LucaLombardini/fft_sylvester_ii/README.txt

################################################################################
#       Progetto di un circuito digitale per il calcolo FFT basato 
#       sull’algoritmo Cooley-Tukey (Project of a digital circuit dedicated to 
#       the FFT calculus based on Cooley-Tuckey algorithm)
################################################################################
#       AUTHORS:
#               Luca Lombardini
#                       Contacts:       s277972@studenti.polito.it
#                                       lombamari2@gmail.com
################################################################################
#       PURPOSE:
#               (Master Degree) Sistemi digitali integrati course's project
################################################################################
#       ACADEMIC YEAR:  2020/2021
################################################################################
#       GOAL:
#               Design in VHDL language a dedicated digital circuit, compliant 
#               to the given specifications, able to calculate the DFT of a 
#               digital input, using the Cooley-Tuckey algorithm. Then document 
#               the obtained performance.
################################################################################
#       LICENSE: GPL-2.0
################################################################################
