LucaLombardini/fft_sylvester_ii/project_files/control_unit.png

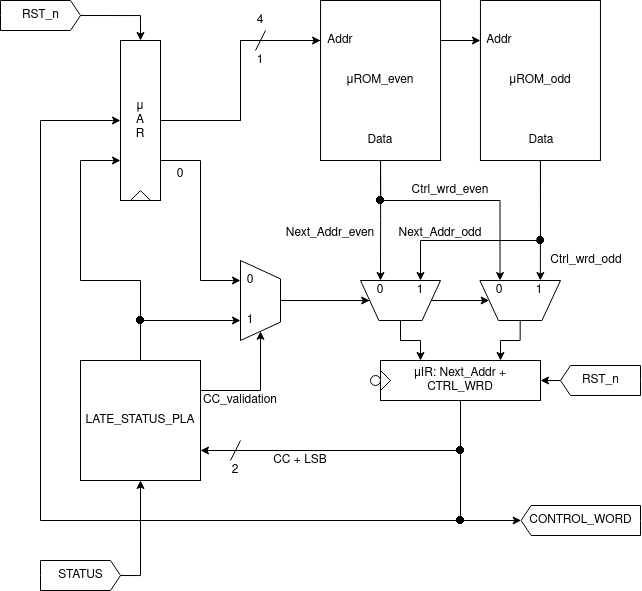
project_files/control_unit.png
