LucaLombardini/fft_sylvester_ii/project_files/ctrlwrds_pt1.png

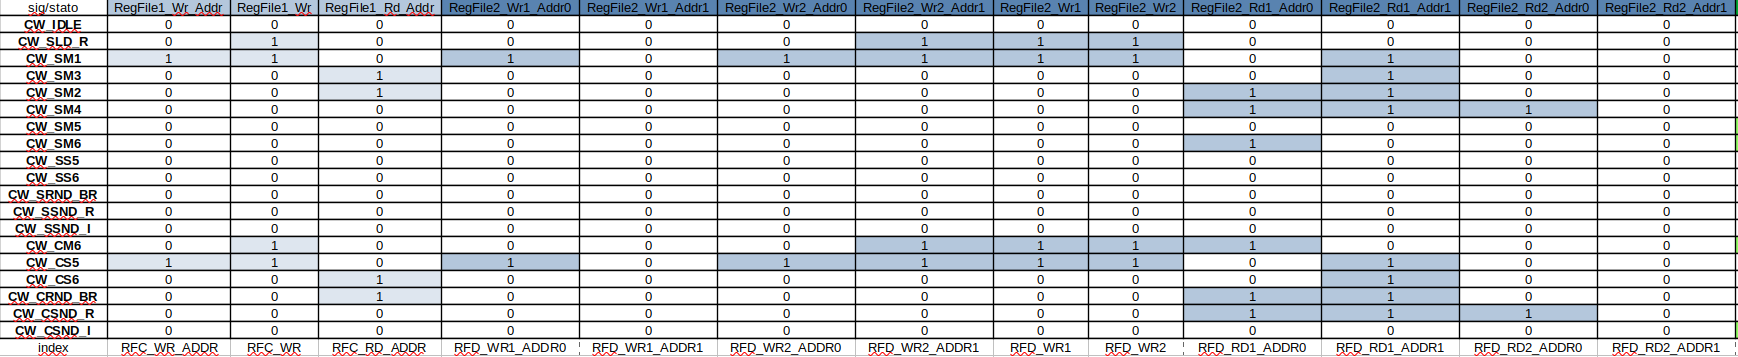
project_files/ctrlwrds_pt1.png
