LucaLombardini/fft_sylvester_ii/project_files/ctrlwrds_pt2.png

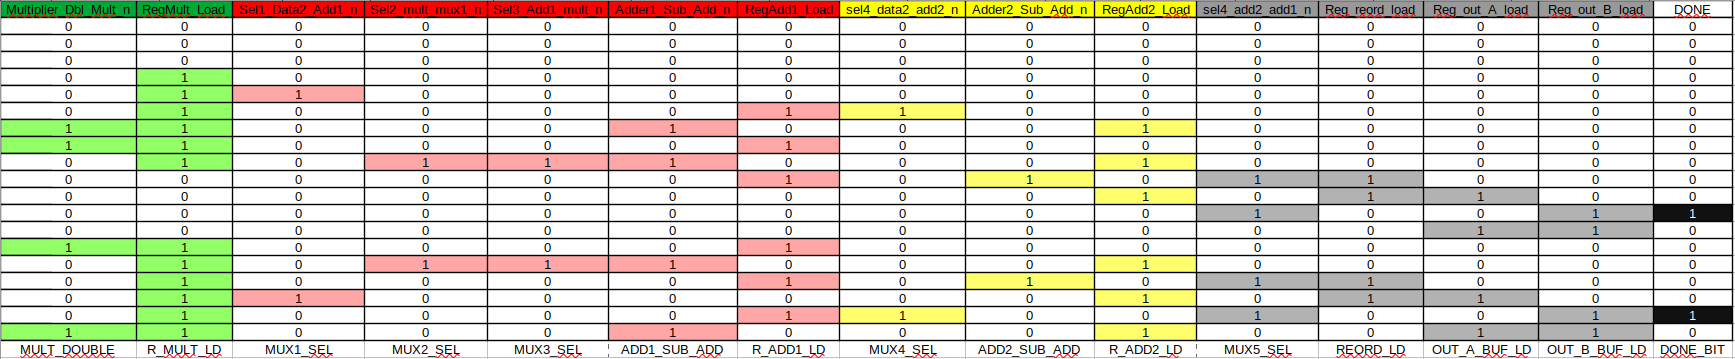
project_files/ctrlwrds_pt2.png
