LucaLombardini/fft_sylvester_ii/project_files/datapath_1_cross.png

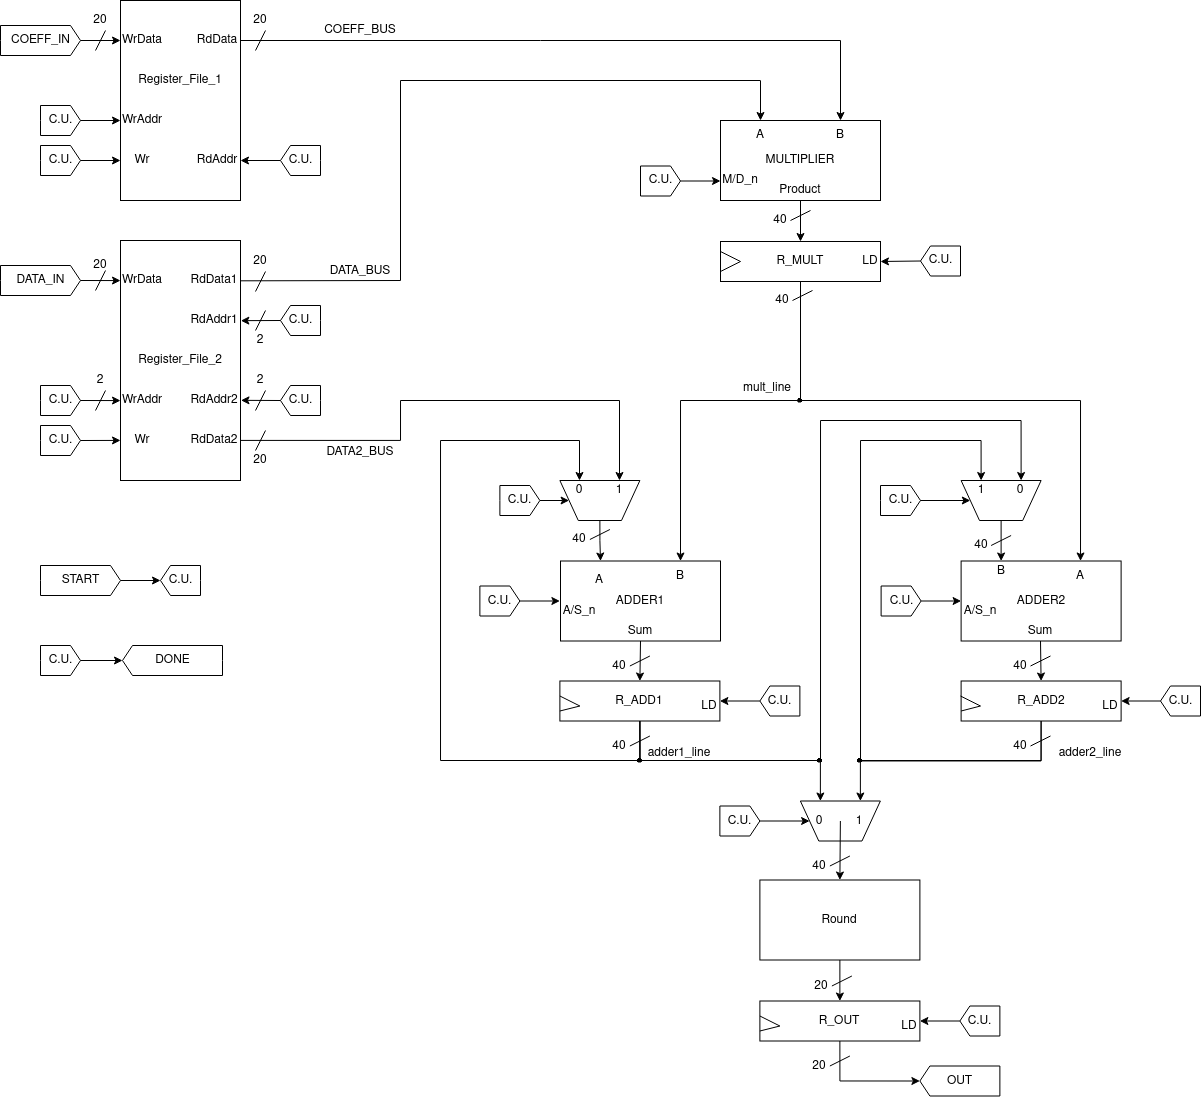
project_files/datapath_1_cross.png
