LucaLombardini/fft_sylvester_ii/project_files/datapath_2.png

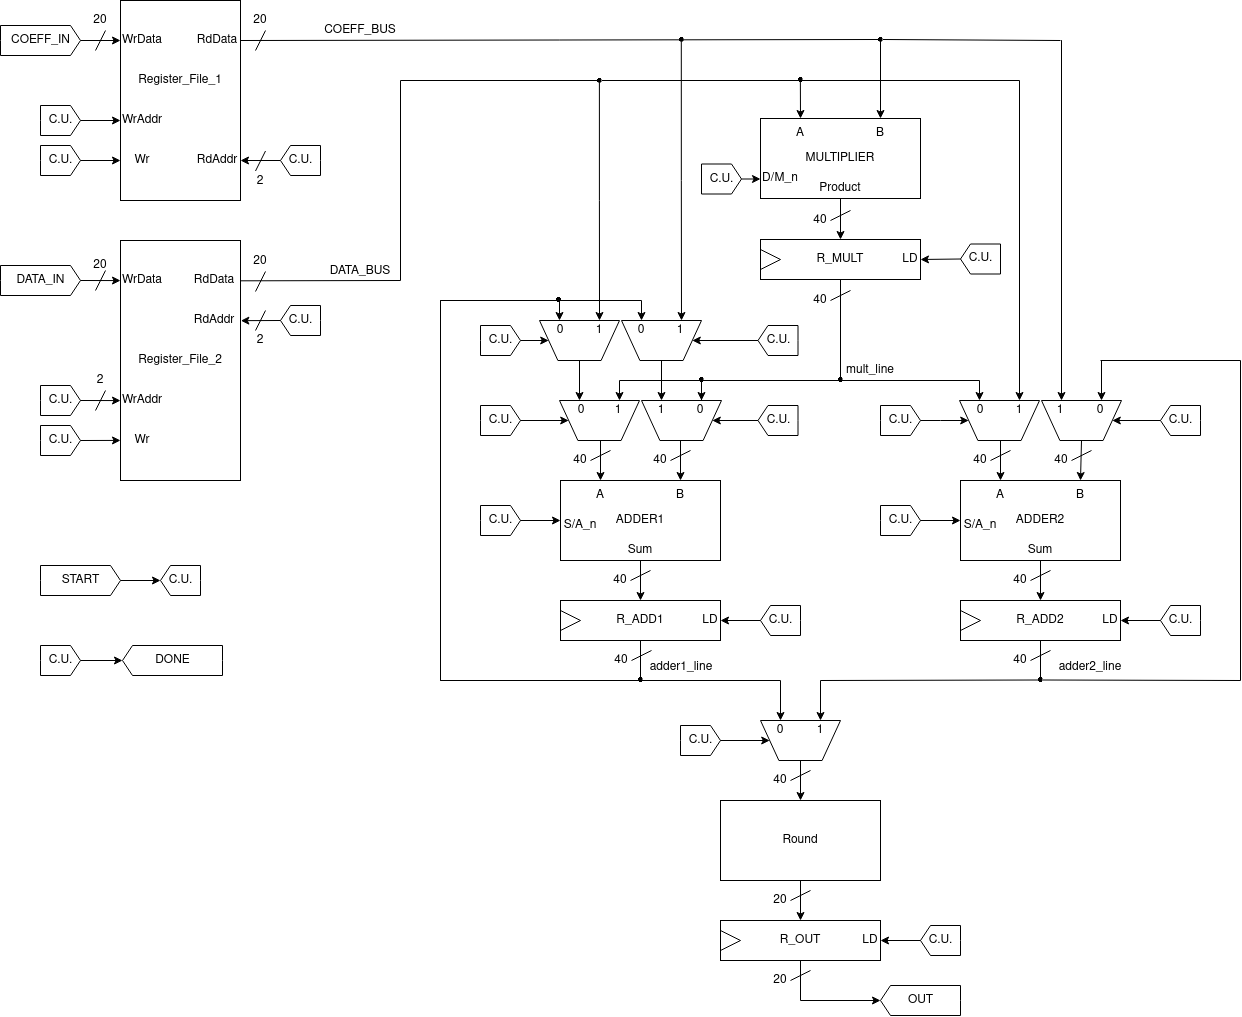
project_files/datapath_2.png
