LucaLombardini/fft_sylvester_ii/project_files/datapath_2_dual_in_nobus.png

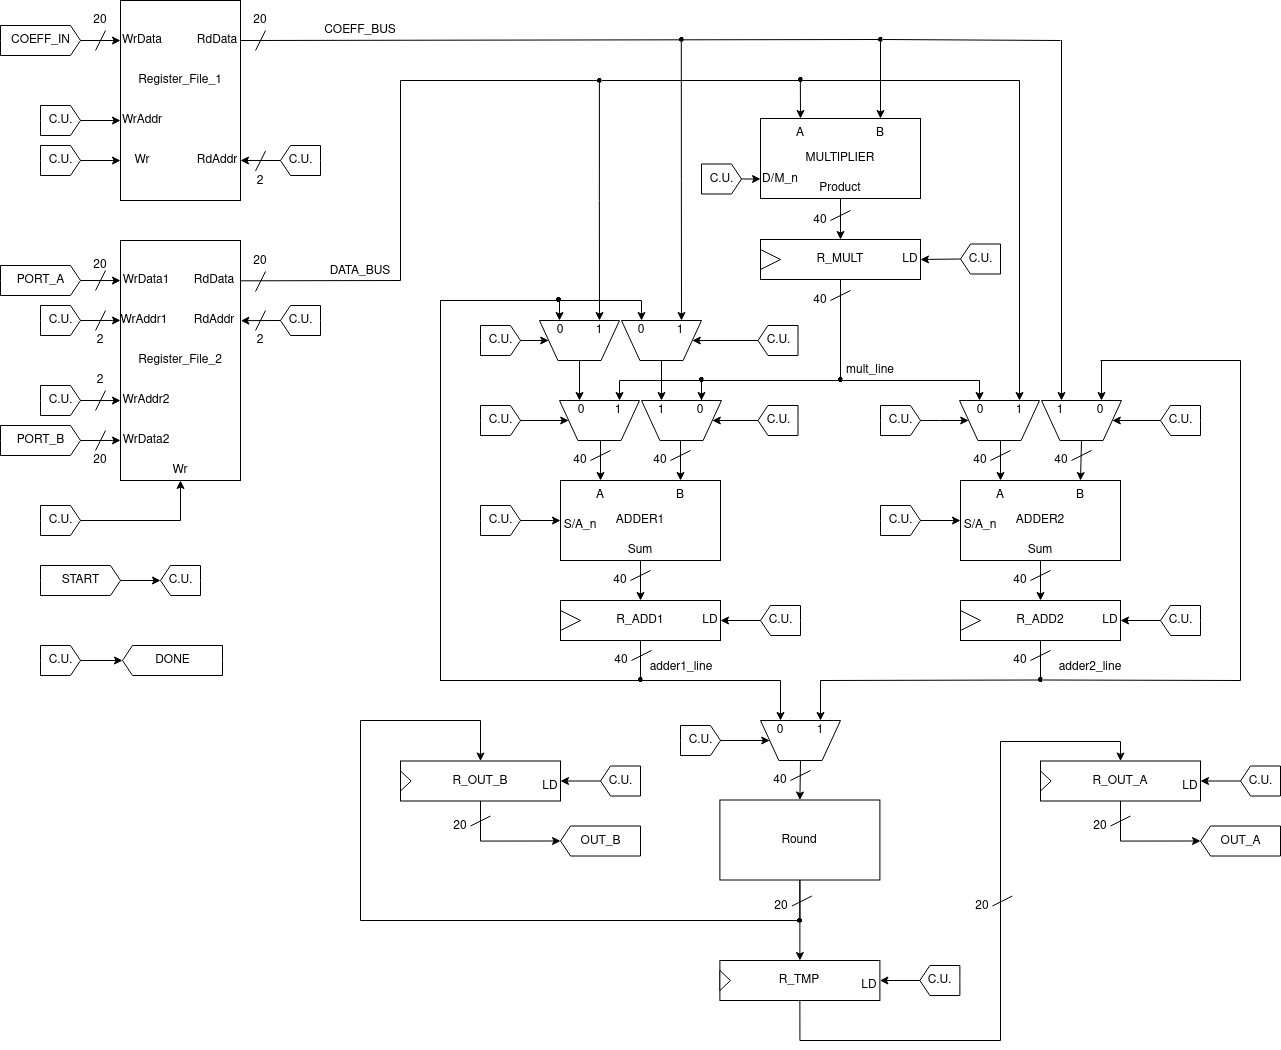
project_files/datapath_2_dual_in_nobus.png
