LucaLombardini/fft_sylvester_ii/project_files/datapath_3.png

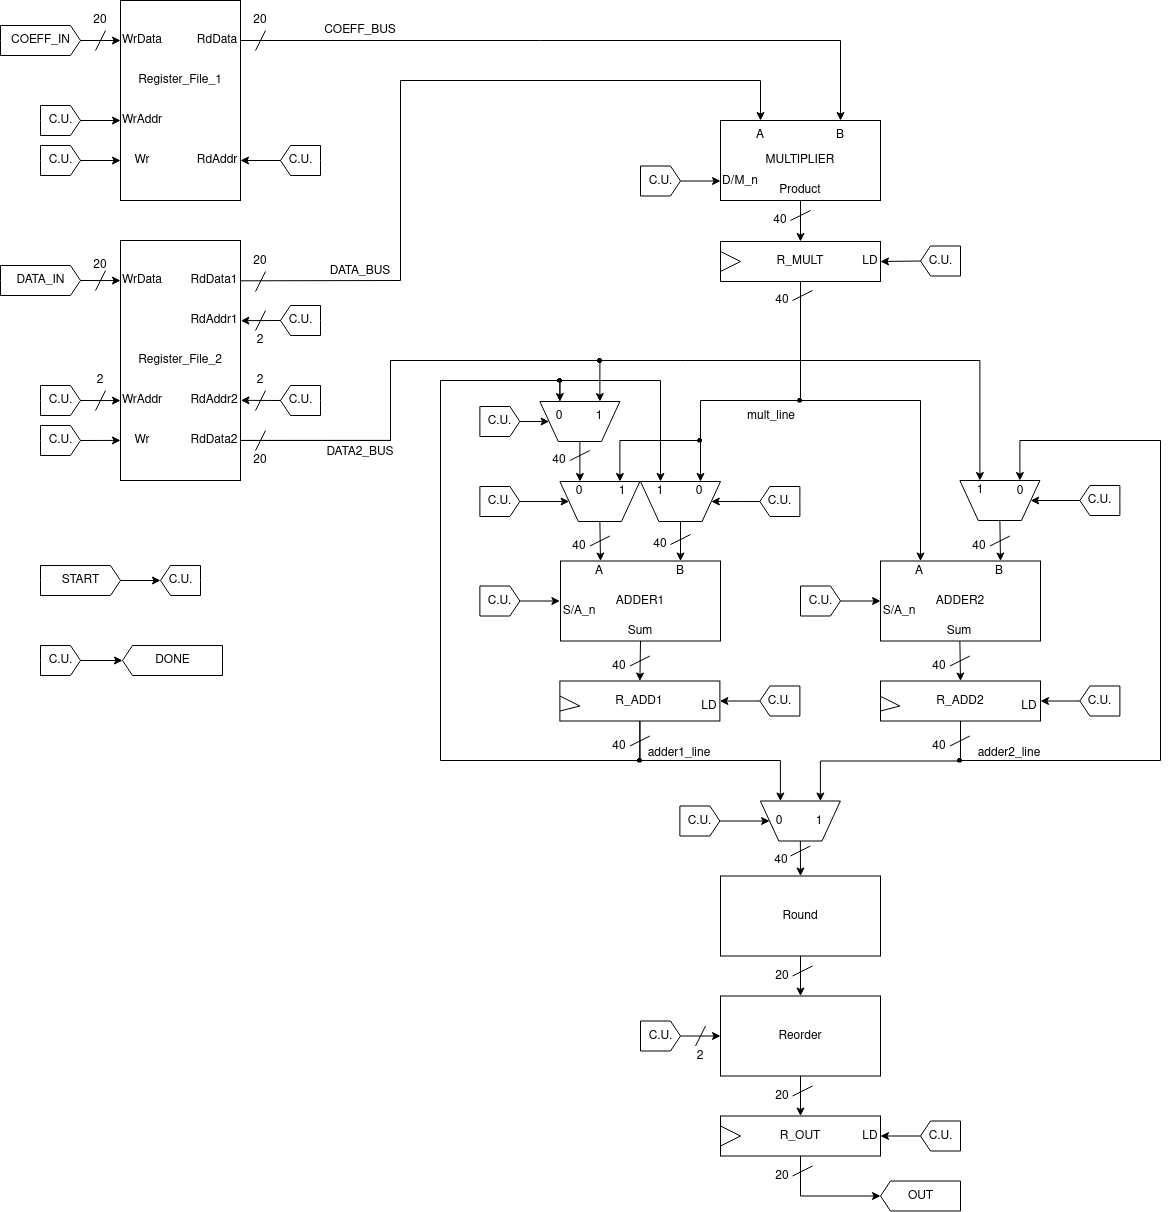
project_files/datapath_3.png
