LucaLombardini/fft_sylvester_ii/project_files/datapath_3_cross.png

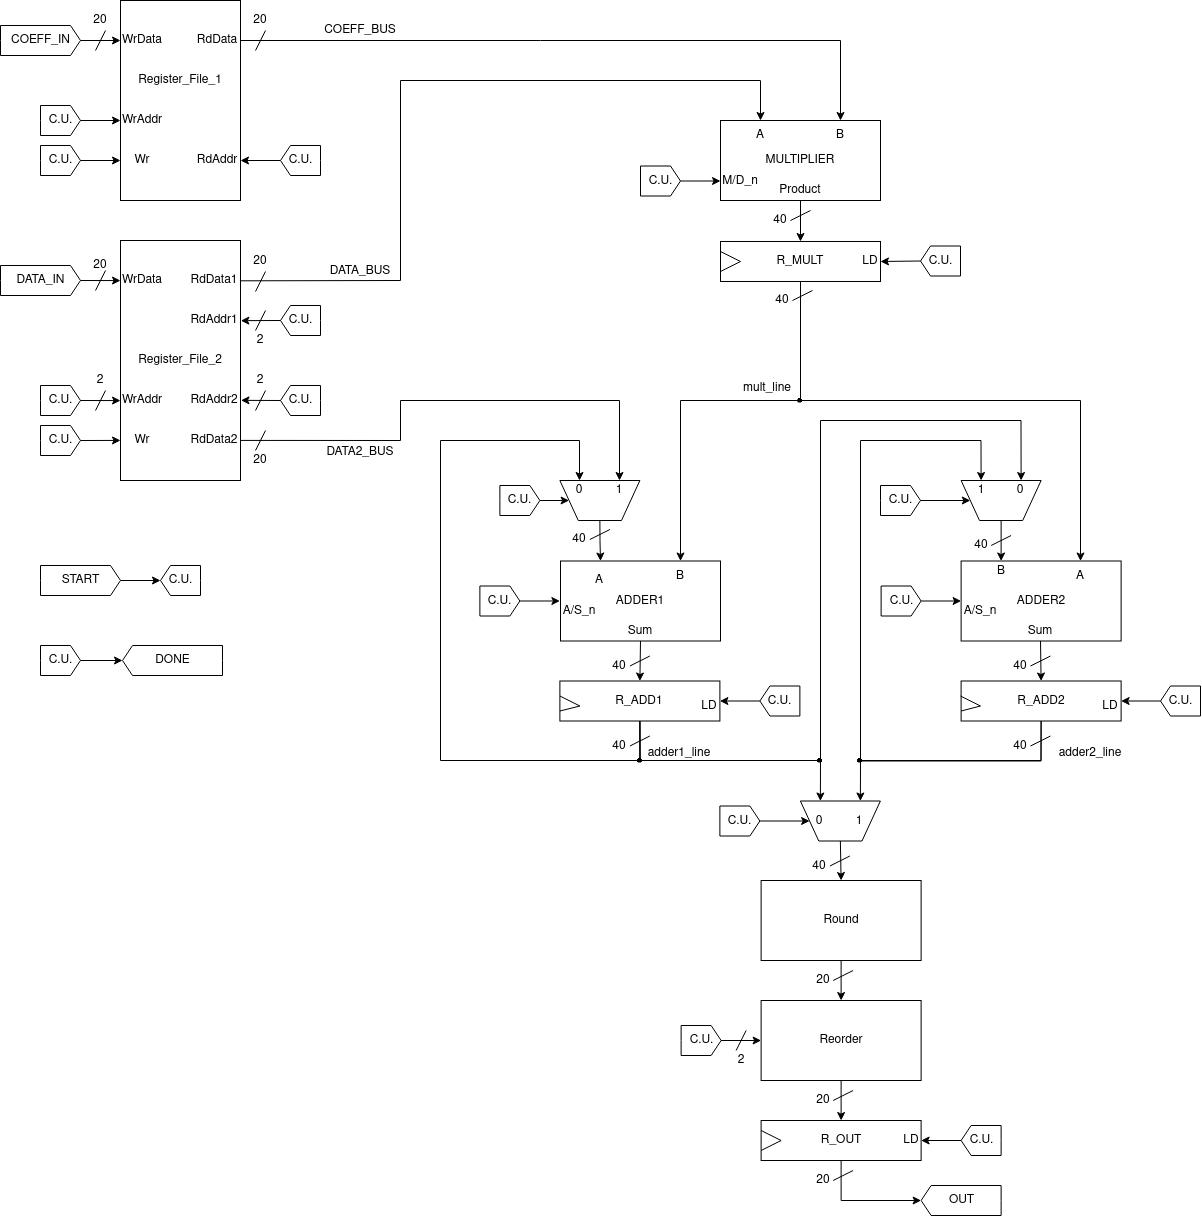
project_files/datapath_3_cross.png
