LucaLombardini/fft_sylvester_ii/project_files/hybrid_2_color.png

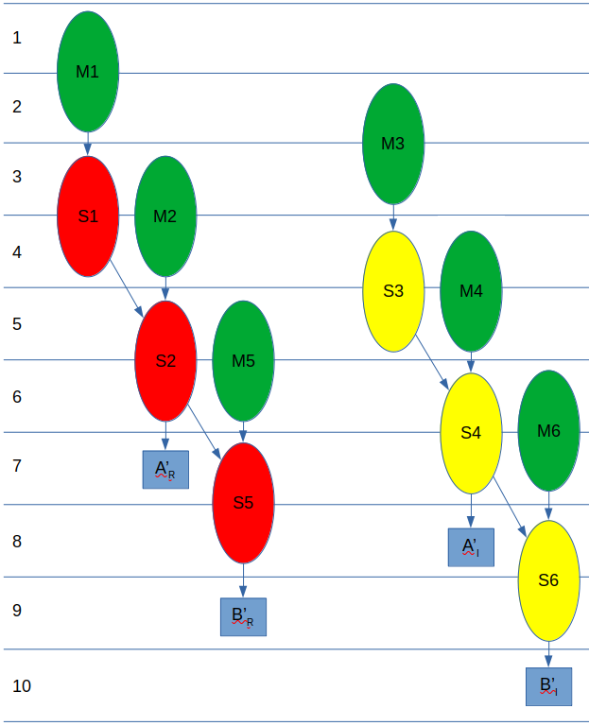
project_files/hybrid_2_color.png
