LucaLombardini/fft_sylvester_ii/project_files/mem_map_states.png

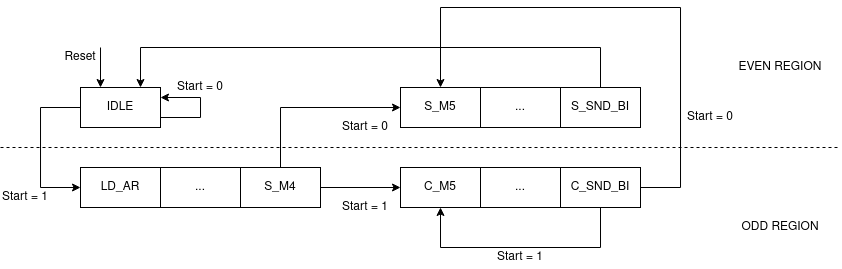
project_files/mem_map_states.png
