LucaLombardini/fft_sylvester_ii/project_files/rom_even.png

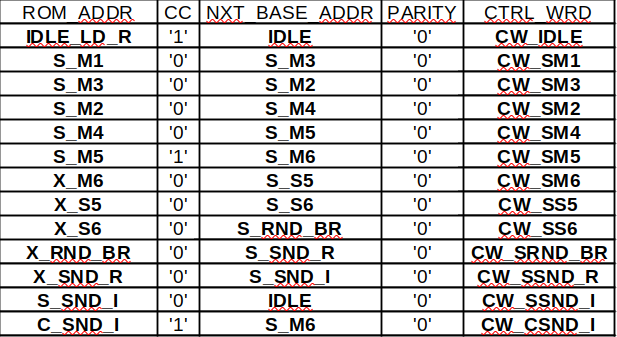
project_files/rom_even.png
