LucaLombardini/fft_sylvester_ii/project_files/simpler_conn.png

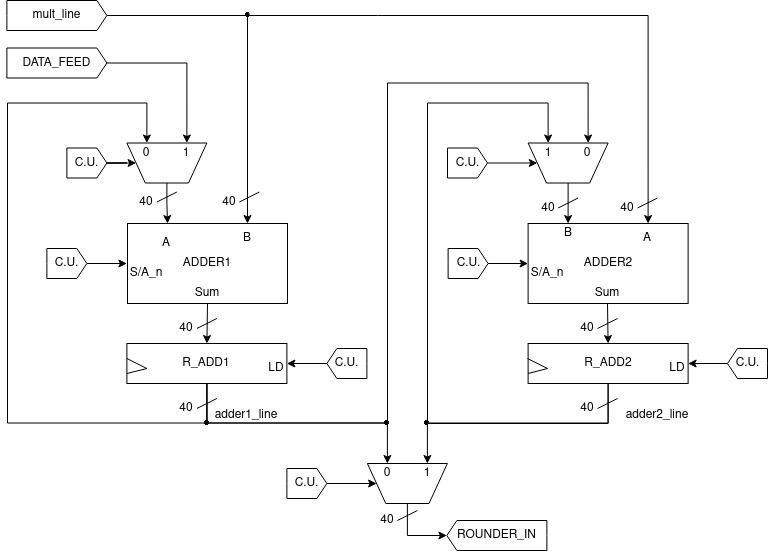
project_files/simpler_conn.png
