LucaLombardini/fft_sylvester_ii/project_files/single_adder.png

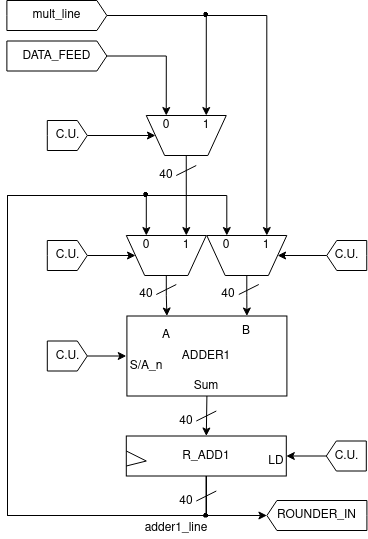
project_files/single_adder.png
