LucaLombardini/fft_sylvester_ii/project_files/state_diag.png

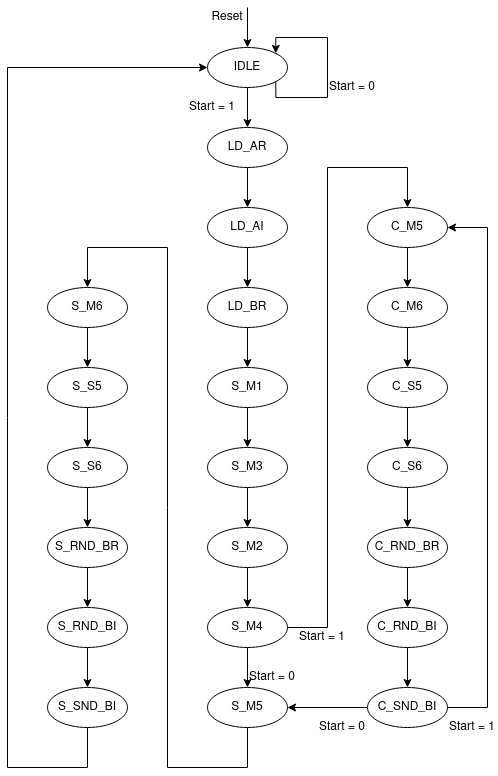
project_files/state_diag.png
