LucaLombardini/fft_sylvester_ii/project_files/var_life_time_double_extra_bus.png

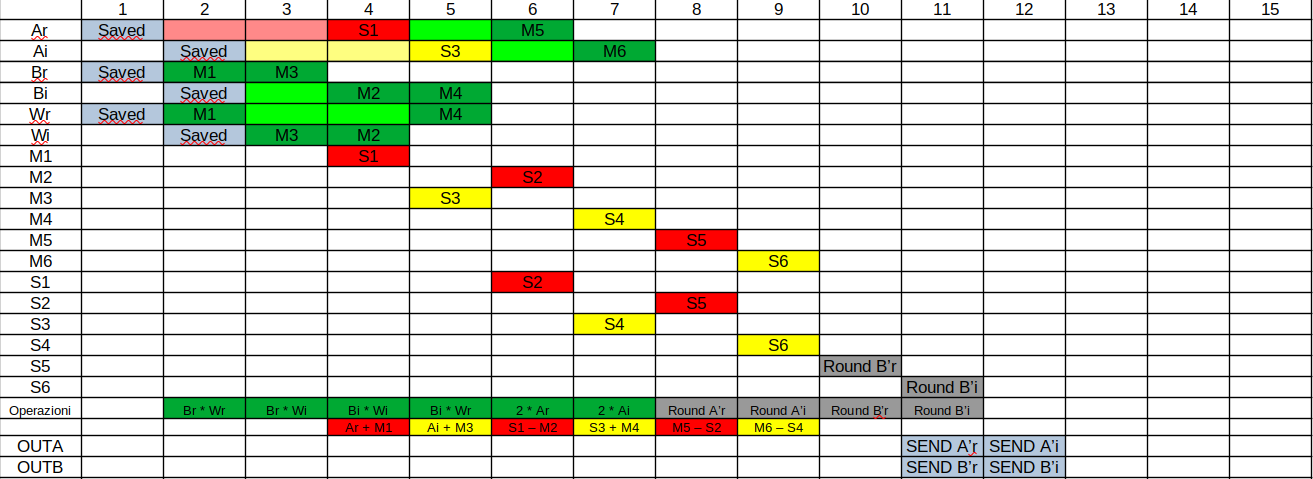
project_files/var_life_time_double_extra_bus.png
