LucaLombardini/fft_sylvester_ii/project_files/var_life_time_double_extra_bus_continuous.png

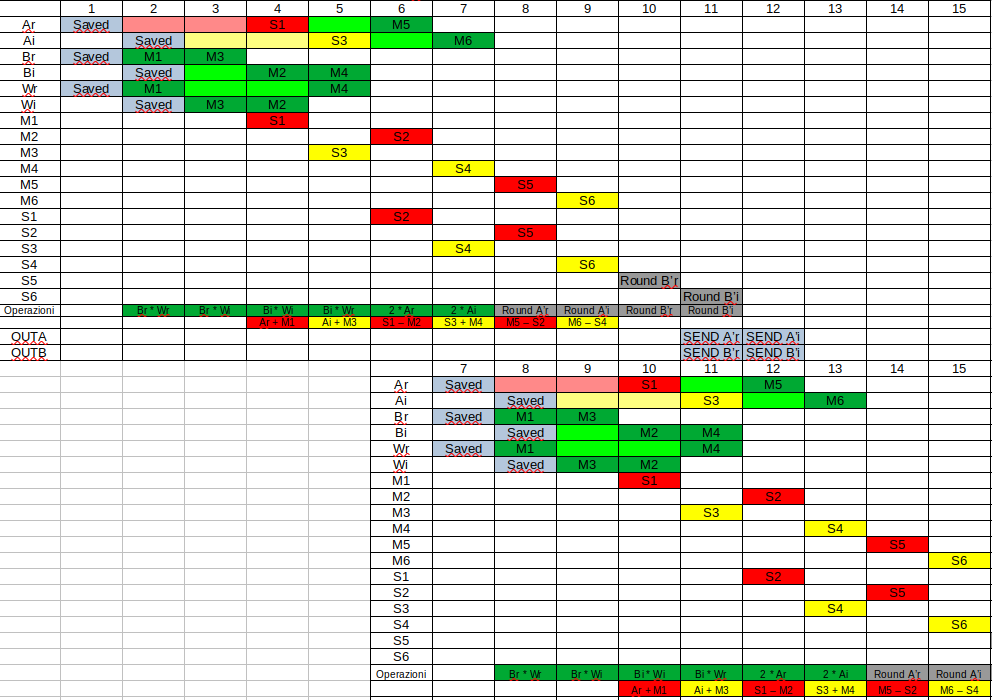
project_files/var_life_time_double_extra_bus_continuous.png
