LucaLombardini/fft_sylvester_ii/project_files/var_life_time_double_reg_reuse.png

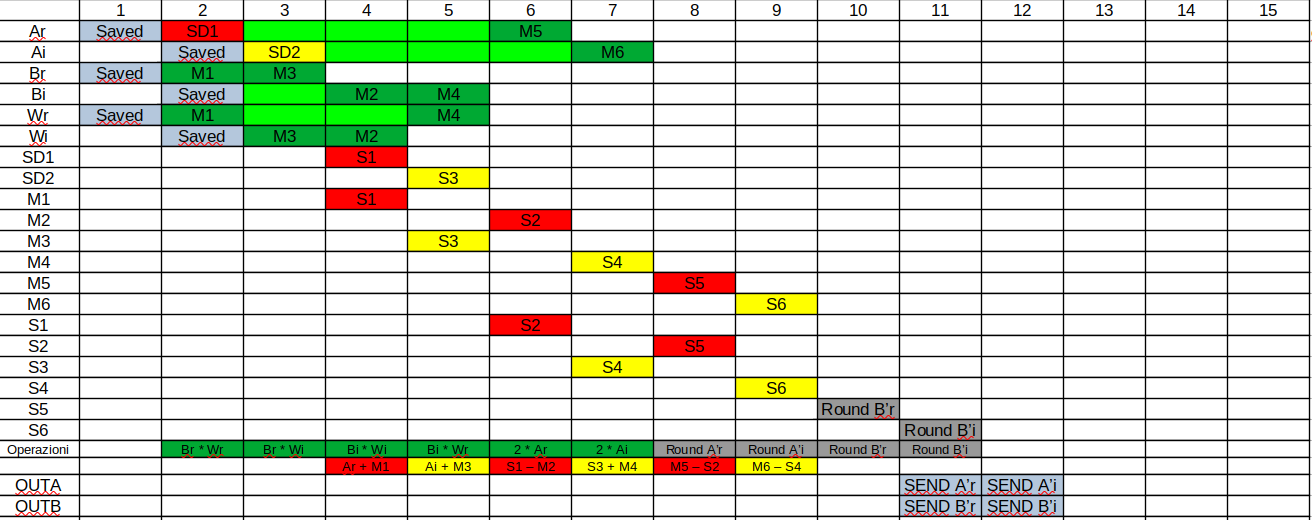
project_files/var_life_time_double_reg_reuse.png
