LucaLombardini/fft_sylvester_ii/project_files/var_life_time_original_out_rev_in_extra_bus.png

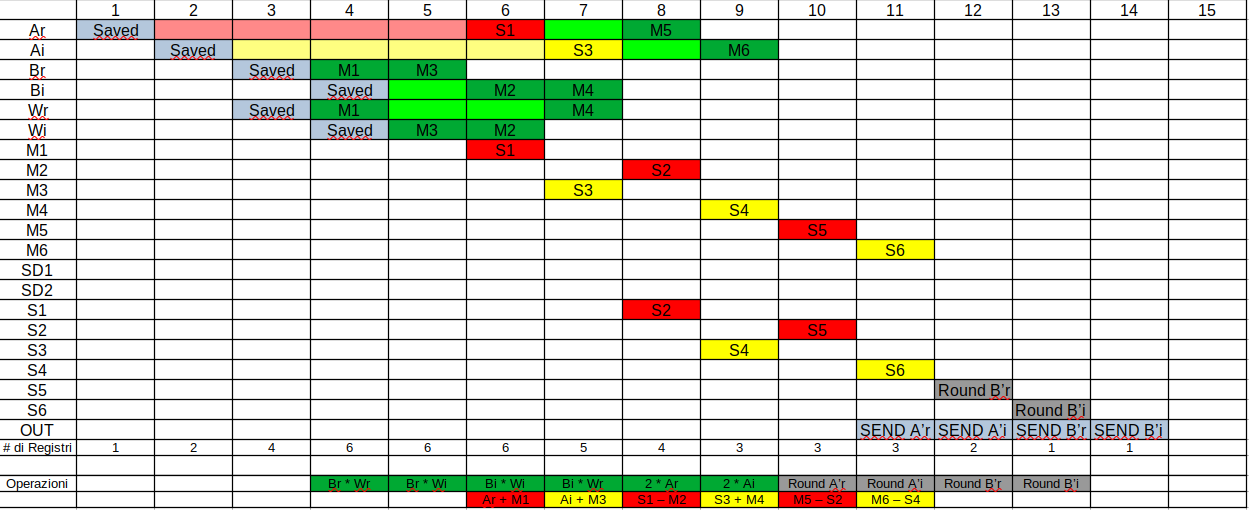
project_files/var_life_time_original_out_rev_in_extra_bus.png
