LucaLombardini/fft_sylvester_ii/project_files/var_life_time_original_out_rev_in_reg_sum_buff_continuous.png

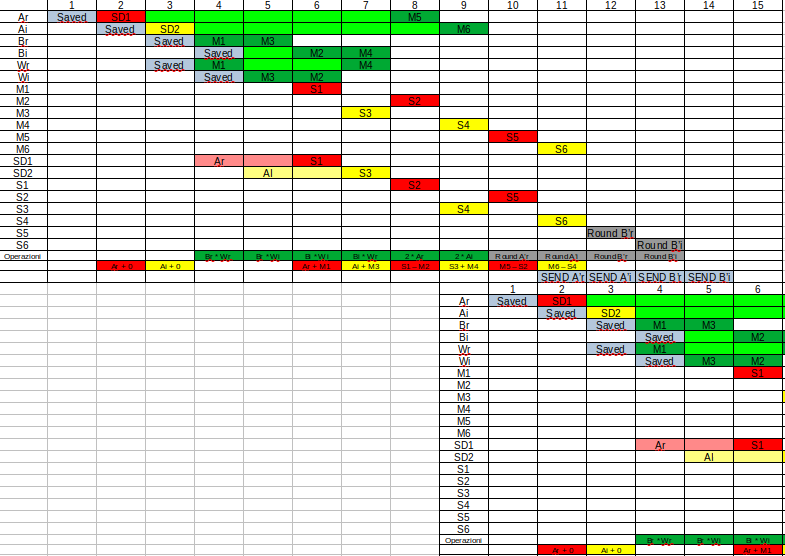
project_files/var_life_time_original_out_rev_in_reg_sum_buff_continuous.png
