LucaLombardini/fft_sylvester_ii/project_files/var_life_time_rev_out_original_in_extra_bus.png

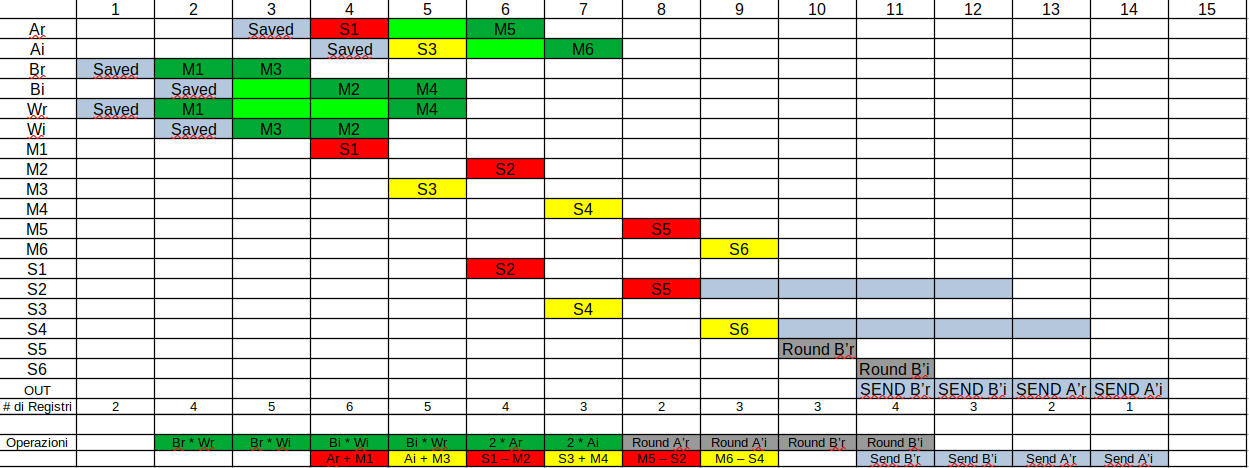
project_files/var_life_time_rev_out_original_in_extra_bus.png
