LucaLombardini/fft_sylvester_ii/py_scr/exp_decr_0-20.png

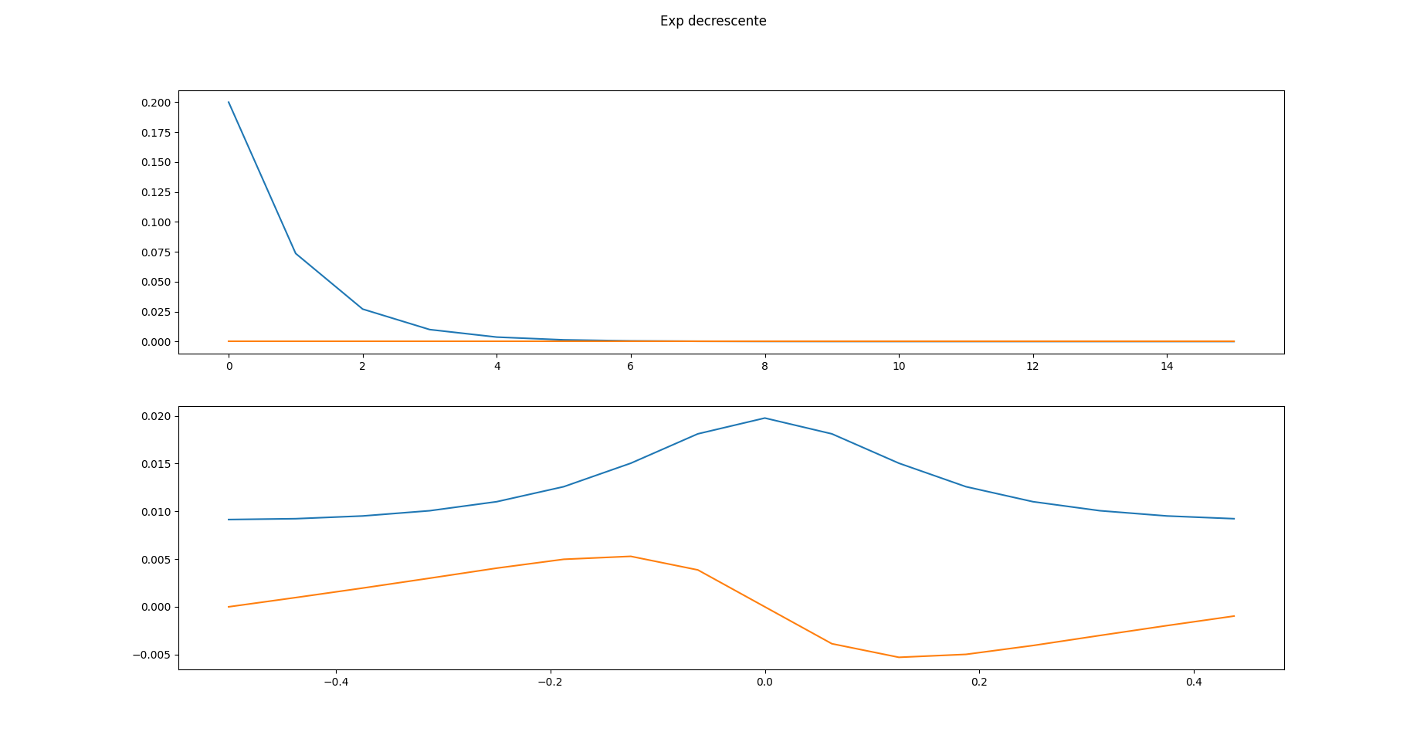
py_scr/exp_decr_0-20.png
