LucaLombardini/fft_sylvester_ii/py_scr/Figure_9.png

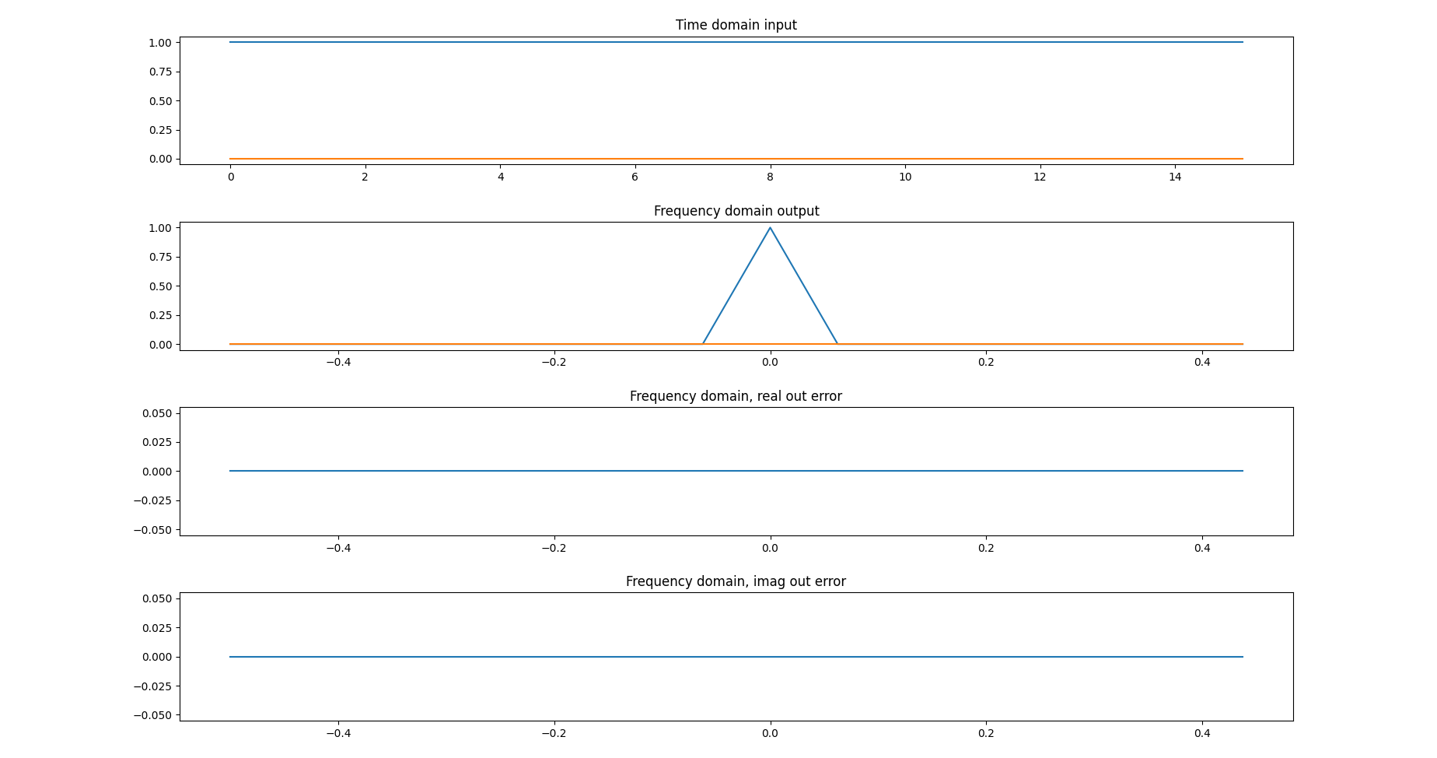
py_scr/Figure_9.png
