LucaLombardini/fft_sylvester_ii/py_scr/Figure_10.png

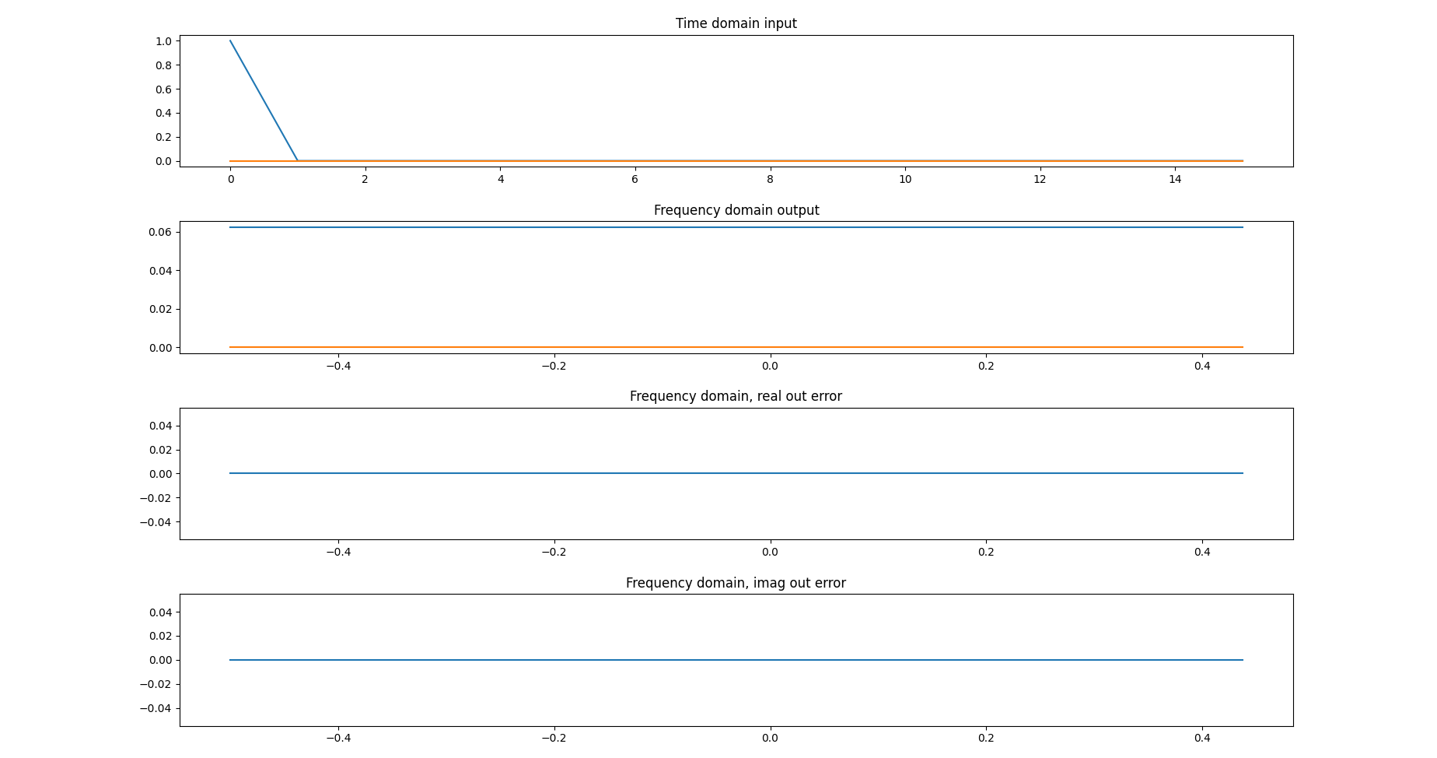
py_scr/Figure_10.png
