LucaLombardini/fft_sylvester_ii/py_scr/Figure_11.png

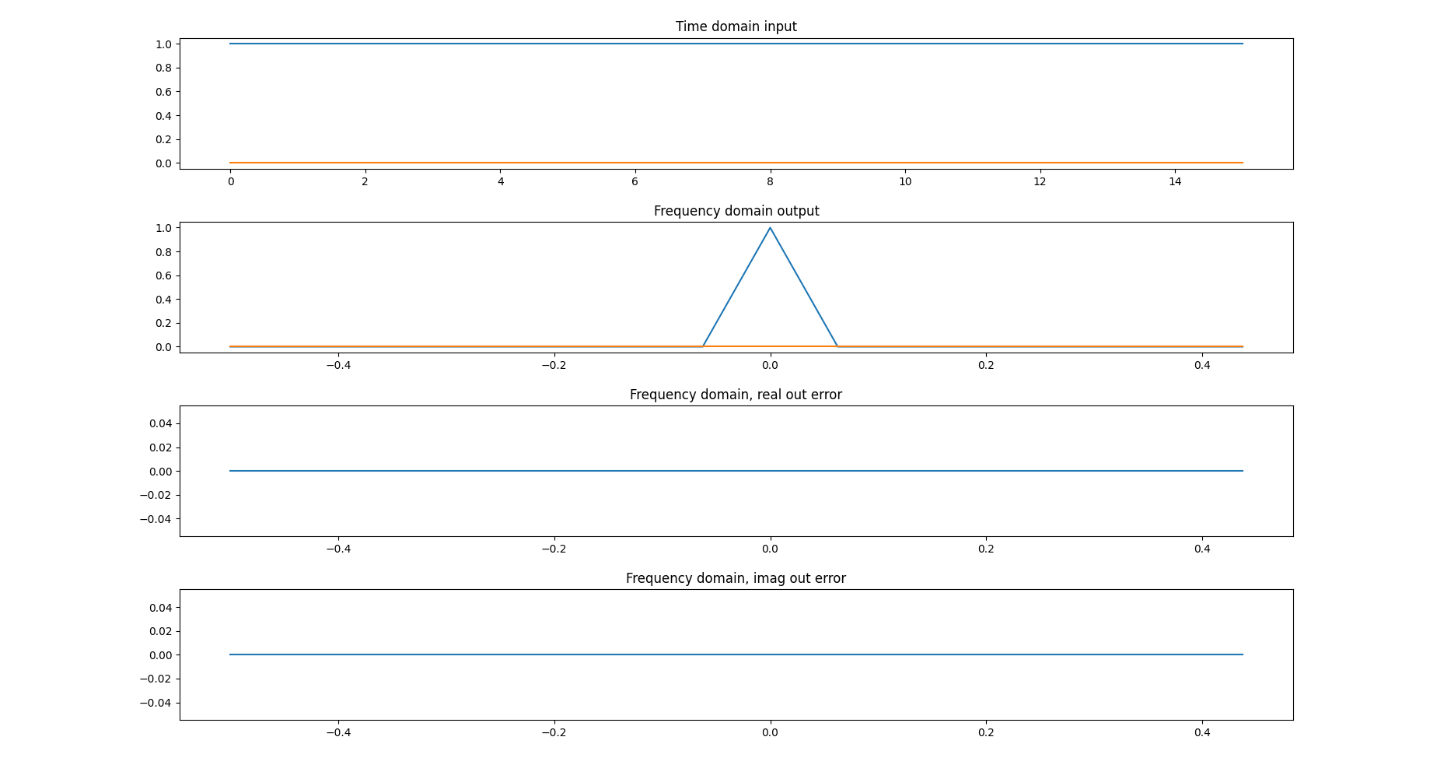
py_scr/Figure_11.png
