LucaLombardini/fft_sylvester_ii/py_scr/Figure_14.png

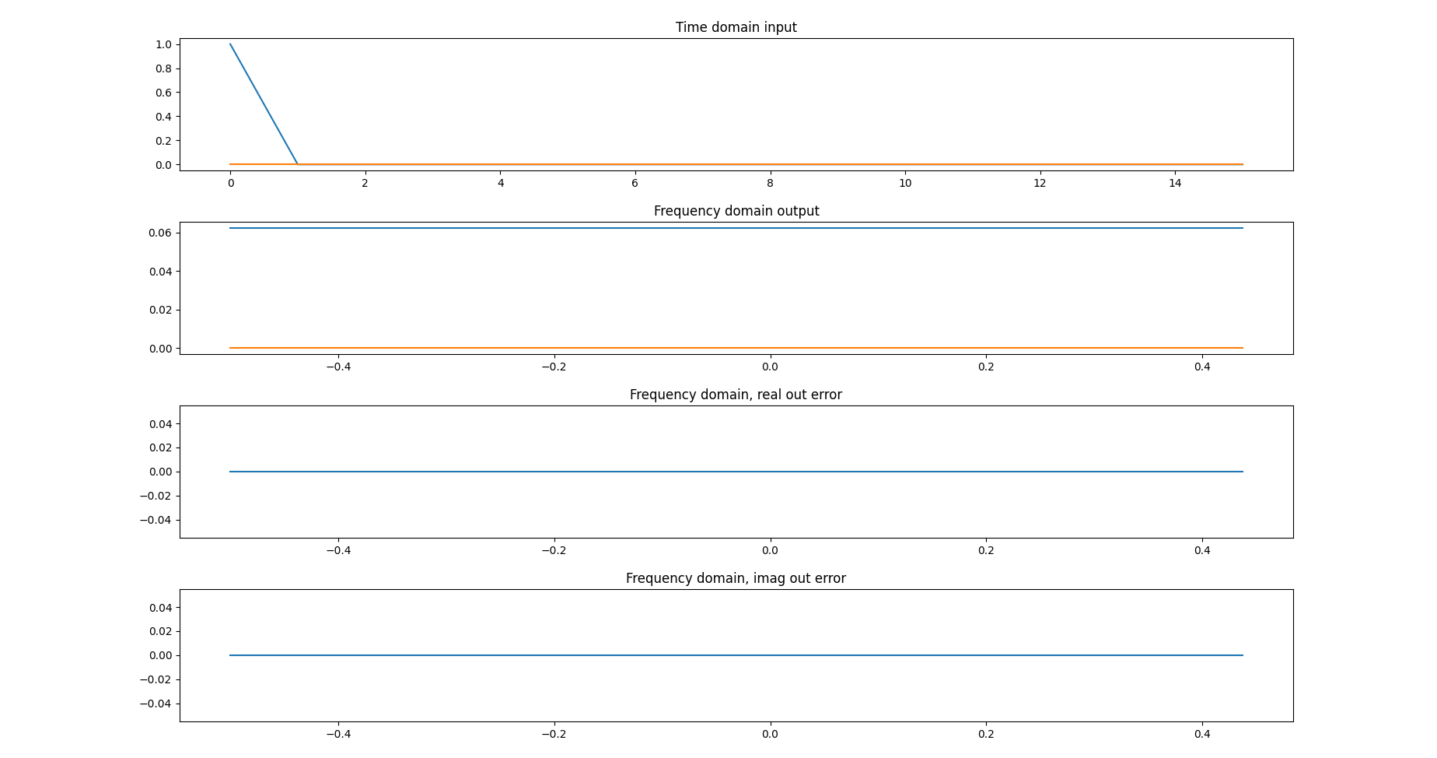
py_scr/Figure_14.png
