LucaLombardini/fft_sylvester_ii/py_scr/Figure_22.png

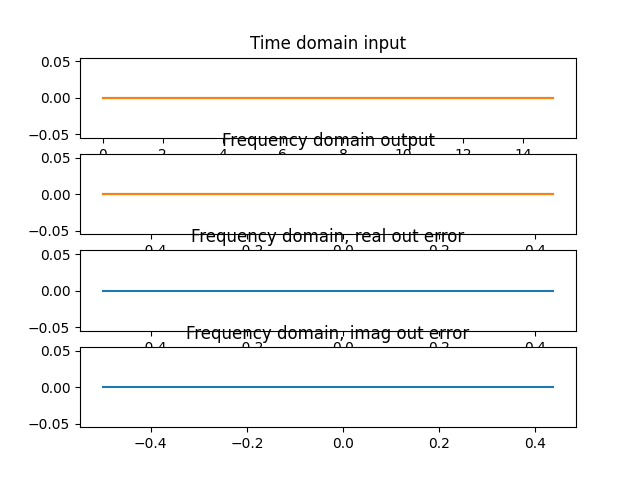
py_scr/Figure_22.png
