LucaLombardini/fft_sylvester_ii/py_scr/Figure_25.png

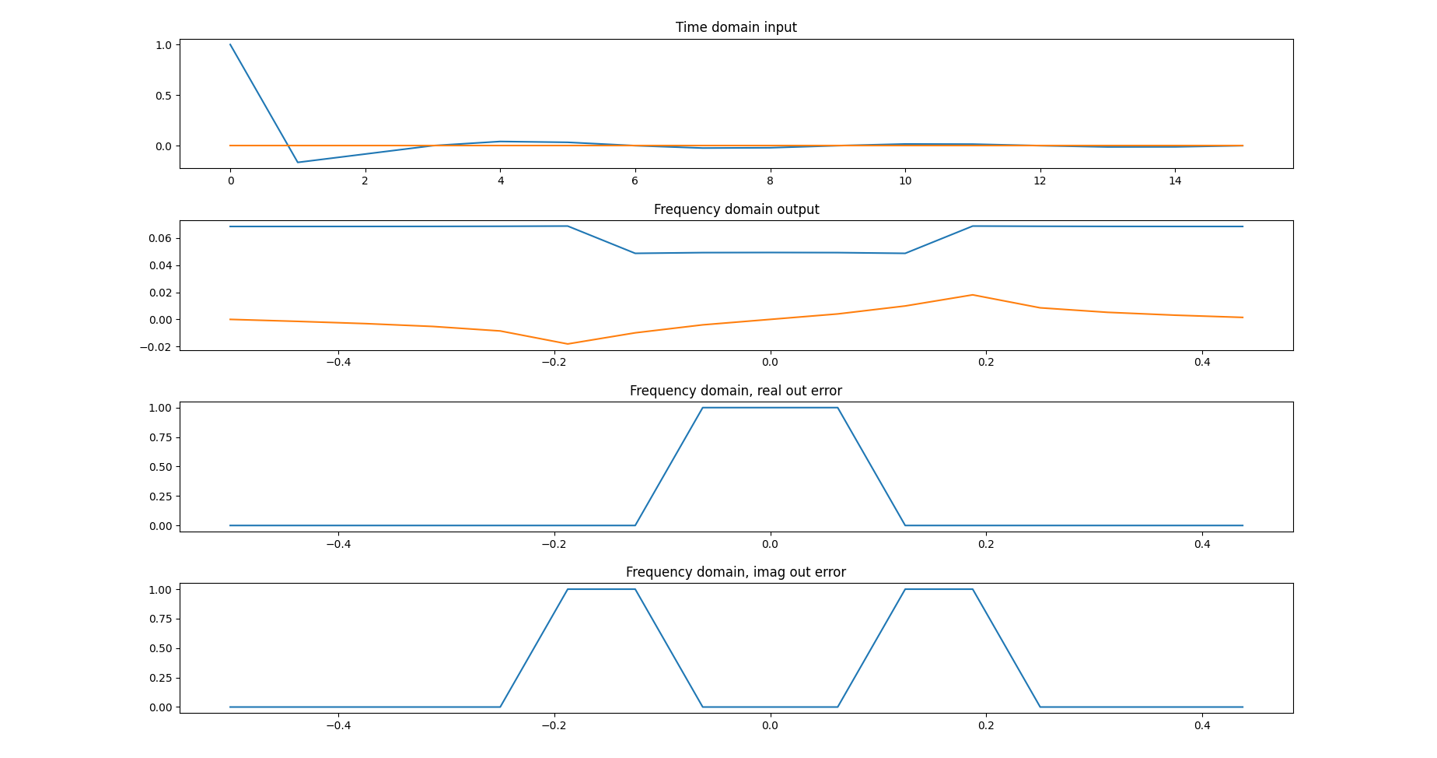
py_scr/Figure_25.png
