LucaLombardini/fft_sylvester_ii/py_scr/Figure_27.png

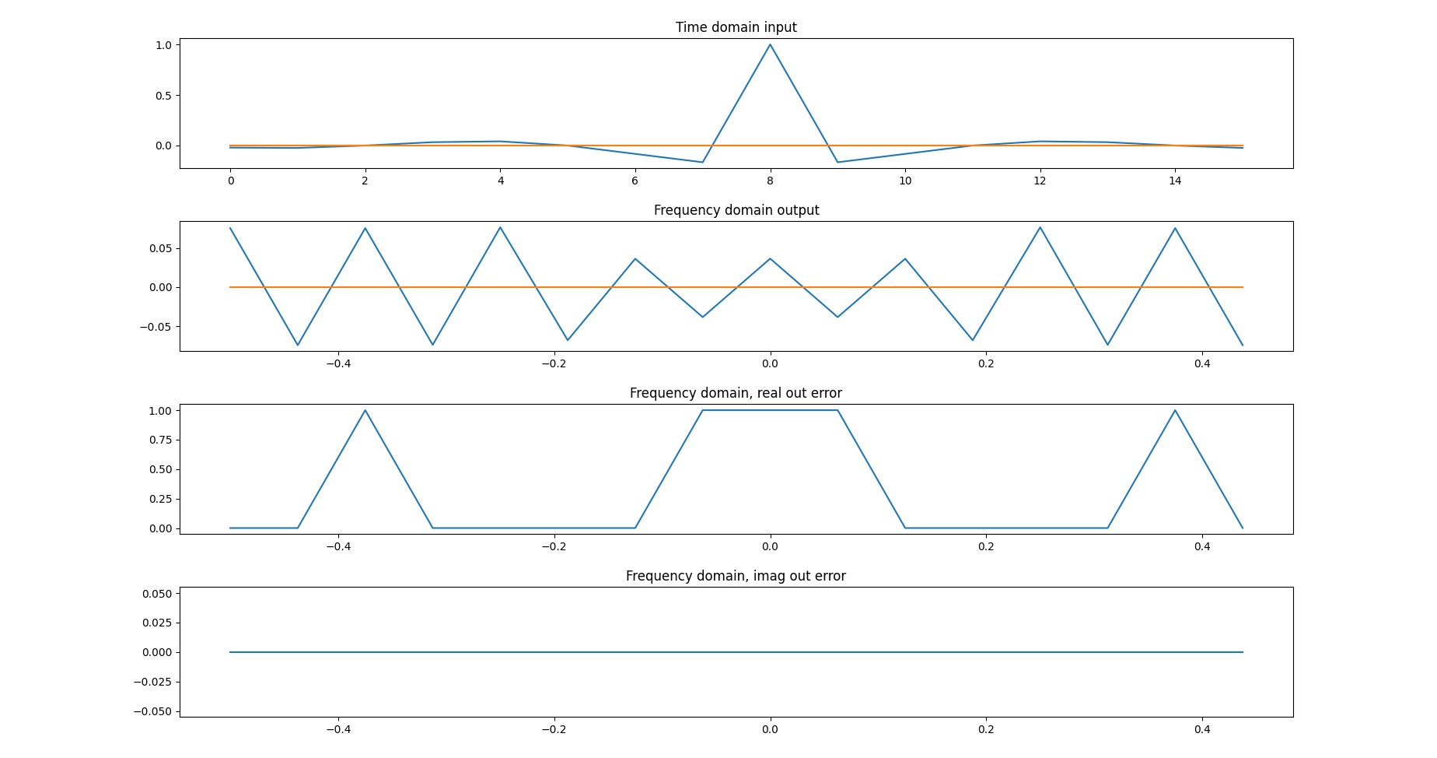
py_scr/Figure_27.png
