LucaLombardini/fft_sylvester_ii/py_scr/Figure_28.png

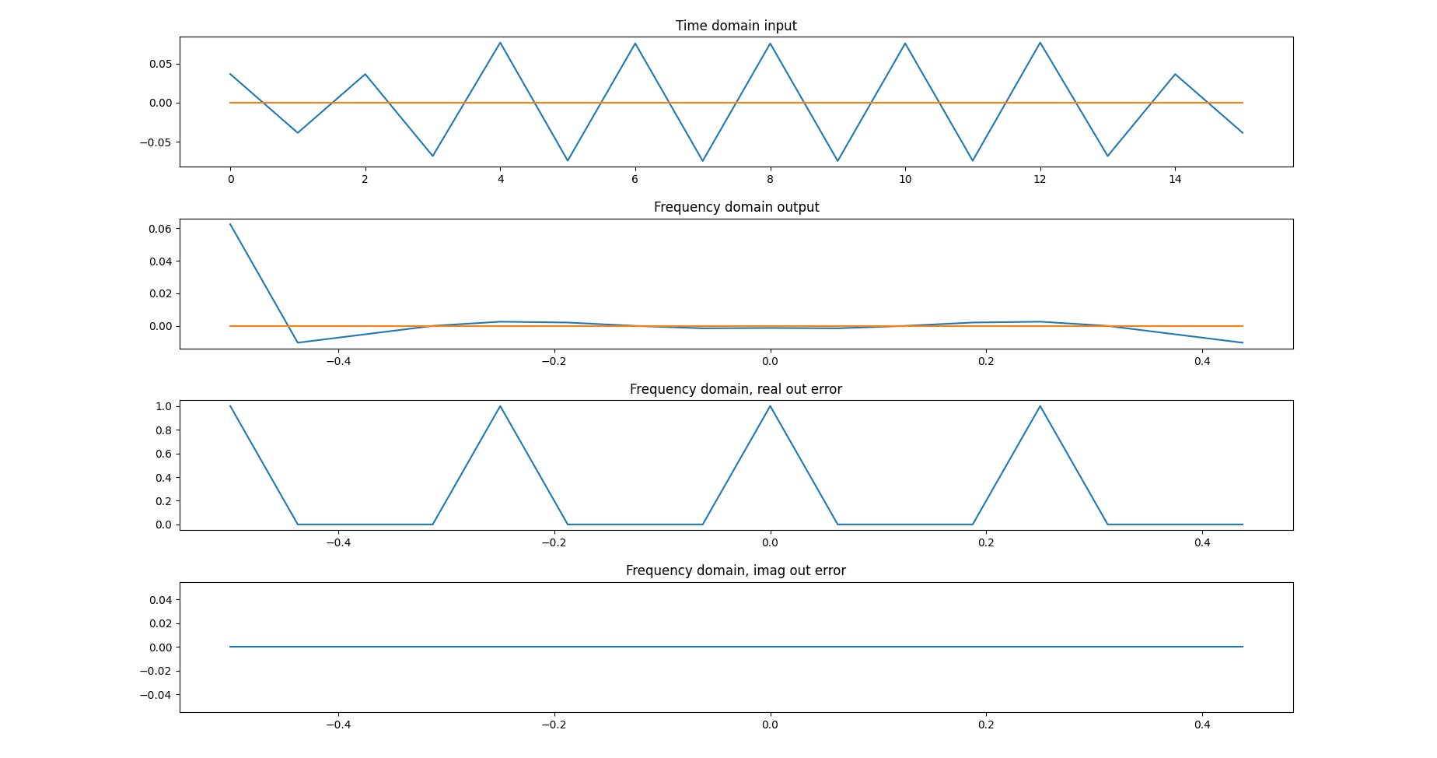
py_scr/Figure_28.png
