LucaLombardini/fft_sylvester_ii/(commit log)

2021-01-12 brkpt1: DP scheme defined, basic component source code, c model source code
    [cu_map.ods, cu_map_test.csv, tempo_vita_var.ods, tempo_vita_var_v2.ods]
2021-01-16 cu start and sim work
    [cu_map.ods, cu_map_even.ods]
2021-01-18 finalized roms creation and unpdating
    [command_gen.csv, command_gen.ods, cu_map.csv, cu_map.ods, cu_map_even.ods, cu_map_odd.ods, pla_command.csv, pla_command.ods]
2021-01-20 rom & cu finalized, cu testbench done. SIM to be done
    [command_gen.ods, ctrlwrds.csv, ctrlwrds.ods, cu_map.csv, cu_map.ods, cu_map_even.ods, cu_map_odd.ods, cu_map_test.csv]
2021-01-20 fixed rom_even
    [rom_even.ods]
2021-01-21 butterfly ready
    [command_gen.csv, ctrlwrds.csv, ctrlwrds.ods, rom_even.csv]
2021-01-22 Wrong output: i suppose wrong out buf ld assertion
    [dataMkrButt.vhd, definespack.vhd, startTimer.vhd, tb_butterfly.vhd]
2021-01-22 BUG: control words were assigned 1 cycle later, my mistake
    [rom_even.csv, rom_even.ods, rom_odd.csv, rom_odd.ods]
2021-01-22 Revert "Wrong output: i suppose wrong out buf ld assertion"
    This reverts commit cb57a7252c6a7aaec437c13f87662e038b7819ec.
    With this commit, the timing is no more valid.
    [dataMkrButt.vhd, definespack.vhd, startTimer.vhd, tb_butterfly.vhd]
2021-01-22 Rom back to previous version
    [rom_even.csv, rom_even.ods, rom_odd.csv, rom_odd.ods]
2021-01-23 Updated ROM: location contains the two possible next addr & actual ctrl words
    [labels.csv, labels.ods, rom_even.csv, rom_even.ods, rom_odd.csv, rom_odd.ods]
2021-01-24 mux selectors and operation signal anticipated
    [ctrlwrds.csv, ctrlwrds.ods]
2021-01-24 Revert "comments remotion"
    This reverts commit b95ca9db76415c5a52aa32cea0de5a3b27809969.
    ctrlwrds now fckd the timing
    [adder.vhd, multiplier.vhd]
2021-01-24 ctrlwrds restored
    [ctrlwrds.csv, ctrlwrds.ods]
2021-01-24 ctrlwrds fixed
    [ctrlwrds.csv, ctrlwrds.ods]
2021-01-24 BUG: C_RND_BI points to the wrong NEXT ADDRESS
    [dataMkrButt.vhd, tb_single.vhd]
2021-01-24 Fixed the CRND_BI bypass
    [labels.csv, labels.ods]
2021-01-24 First small battery simulation: VERIFIED
2021-01-28 ERROR: BUTTERFLY IS NOT INTERFACEABLE
    [definespack.vhd, fft_unit.vhd]
2021-01-28 New Butterfly: triple in-port and double out-port
    [ctrlwrds.csv, ctrlwrds.ods, labels.csv, labels.ods, rom_even.csv, rom_even.ods, rom_odd.csv, rom_odd.ods]
2021-01-28 Rom had wrong labes
    [rom_even.csv, rom_even.ods, rom_odd.csv, rom_odd.ods]
2021-01-28 more label issues
    [labels.csv, labels.ods, rom_even.csv, rom_even.ods, rom_odd.csv, rom_odd.ods]
2021-01-28 even more label mess
    [rom_even.csv, rom_even.ods, rom_odd.csv, rom_odd.ods]
2021-01-29 adder additional wr bit for data regfile
    [ctrlwrds.csv, ctrlwrds.ods]
2021-02-01 FFT: simulation has wrong out order
    [dataMkrFft.vhd, tb_fft.vhd]
2021-02-01 FFT: fixed order mismatch and out from c_model
    [fft_unit.vhd]
2021-02-01 FFT: model updated to track in-between leves partials
